nanachan3835/AIR-QUALITY-SENSOR-FIX/pic/ScreenShot_2026-11-03_133047_207.png

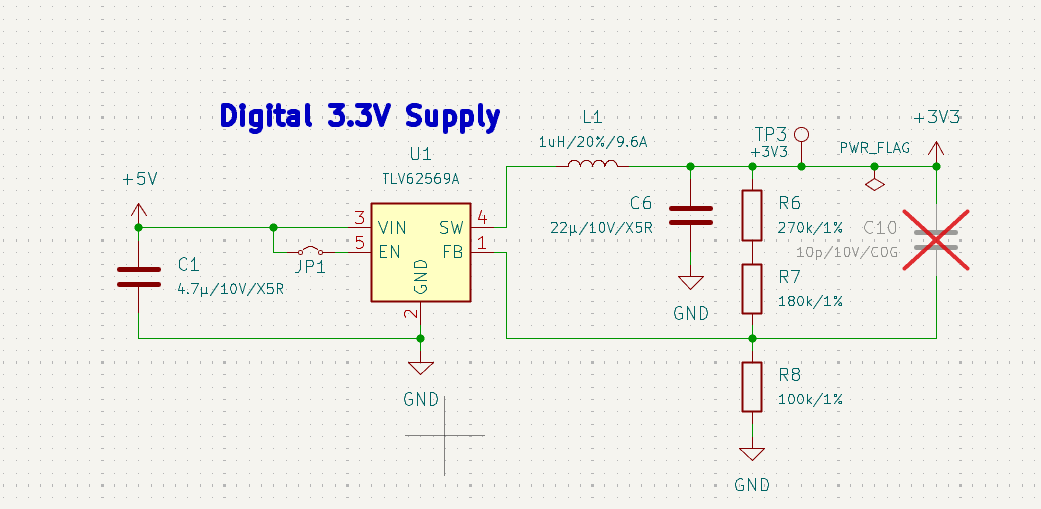
pic/ScreenShot_2026-11-03_133047_207.png
