nanachan3835/AIR-QUALITY-SENSOR-FIX/pic/ScreenShot_2026-11-03_133104_901.png

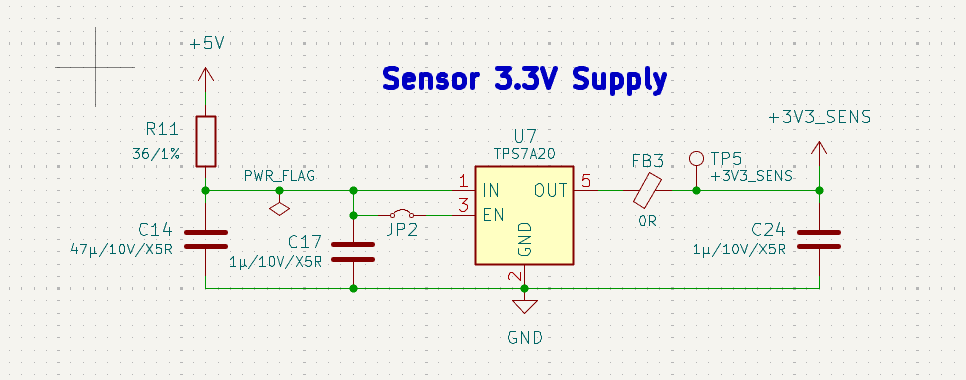
pic/ScreenShot_2026-11-03_133104_901.png
