nanachan3835/AIR-QUALITY-SENSOR-FIX/pic/ScreenShot_2026-11-03_133211_923.png

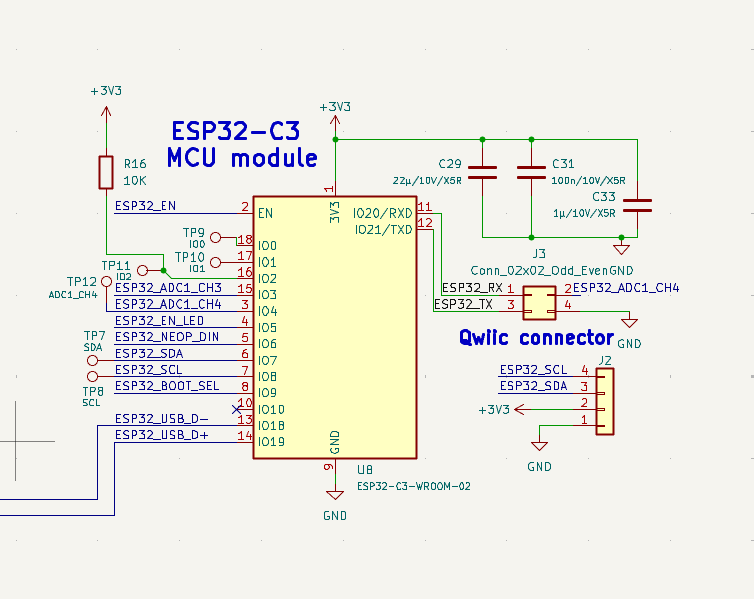
pic/ScreenShot_2026-11-03_133211_923.png
