nanachan3835/AIR-QUALITY-SENSOR-FIX/pic/ScreenShot_2026-11-03_133233_049.png

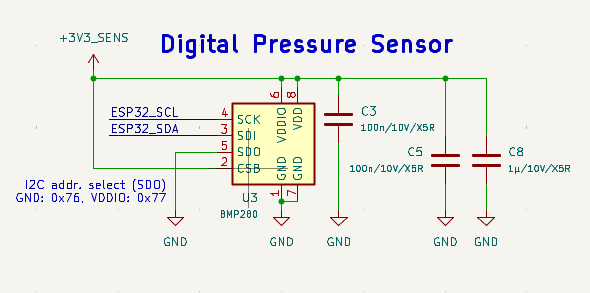
pic/ScreenShot_2026-11-03_133233_049.png
