nanachan3835/AIR-QUALITY-SENSOR-FIX/pic/ScreenShot_2026-11-03_133306_155.png

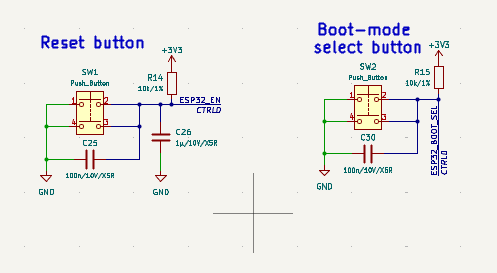
pic/ScreenShot_2026-11-03_133306_155.png
