nanachan3835/AIR-QUALITY-SENSOR-FIX/3dmodels/SGP41-D-R4.step

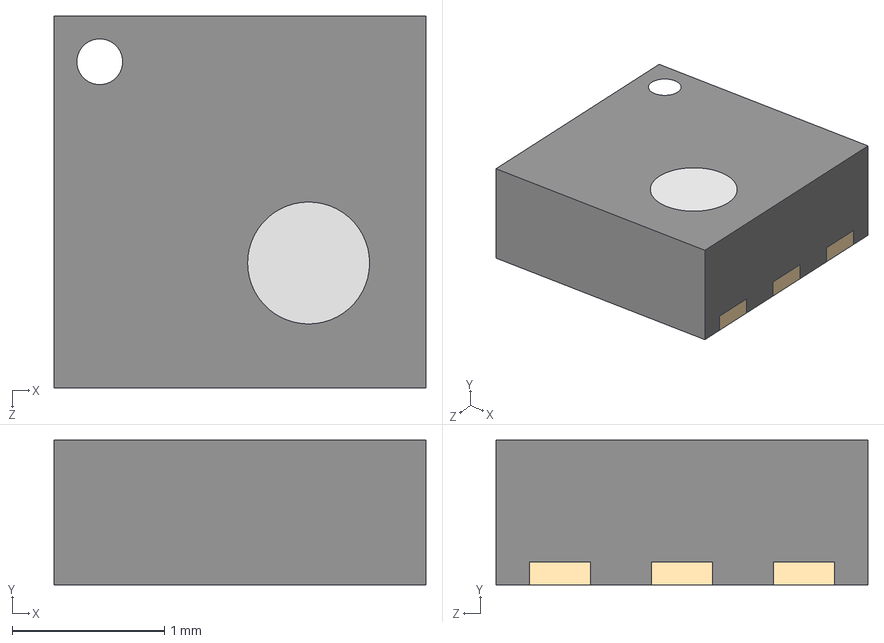
[picture p15: CAD file, 2026-10-27]
3dmodels/SGP41-D-R4.step
2.44 x 0.95 x 2.44 mm
