nanachan3835/AIR-QUALITY-SENSOR-FIX/air_quality_sensor-pcb.step

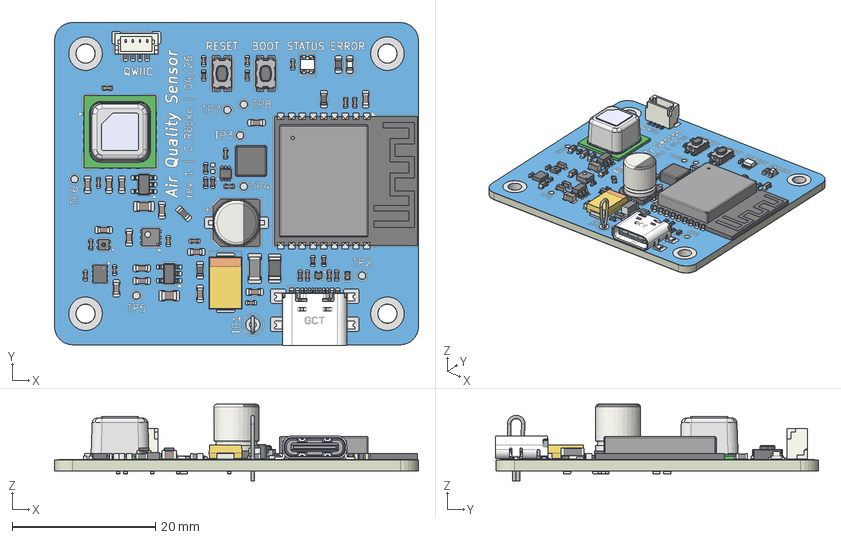
[picture p16: CAD file, 2026-10-27]
air_quality_sensor-pcb.step
50.8 x 45.1 x 10.7 mm
SGP41-D-R4
R_0402_1005Metric x 16
SCD41-D-R2--3DModel-STEP-369182
C_0603_1608Metric x 12
C_0402_1005Metric x 17
C_0805_2012Metric x 2
R_0603_1608Metric x 4
USB4110-GF-A_revB(1) MF
CP_EIA-7343-20_Kemet-V
SW_Push_1P1T_NO_CK_KMR2 x 2
CP_Elec_6.3x7.7
LED_0603_1608Metric
SOT-563
SHT40-AD1B-R3
L_Coilcraft_XAL4020-XXX
TestPoint_Loop_D2.50mm_Drill1.0mm
WS2812-2020--3DModel-STEP-1
Texas_DRT-3
SOT-23-5 x 2
D_SOD-882
ESP32-C3-WROOM-02
L_1206_3216Metric
Bosch_LGA-8_2x2.5mm_P0.65mm_ClockwisePinNumbering
L_0603_1608Metric x 2
JST_SH_BM04B-SRSS-TB_1x04-1MP_P1.00mm_Vertical
Fuse_1206_3216Metric
air_quality_sensor_copper
air_quality_sensor_pad
air_quality_sensor_via
air_quality_sensor_silkscreen x 2
air_quality_sensor_soldermask x 2
air_quality_sensor_PCB
