nanachan3835/AIR-QUALITY-SENSOR-FIX/3dmodels/USB4110-GF-A.step

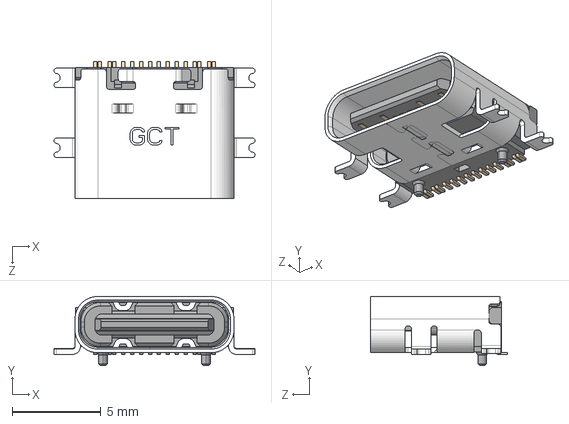
[picture p17: CAD file, 2026-10-27]
3dmodels/USB4110-GF-A.step
11.3 x 3.89 x 7.70 mm
