nanachan3835/AIR-QUALITY-SENSOR-FIX/3dmodels/WS2812-2020--3DModel-STEP-1.STEP

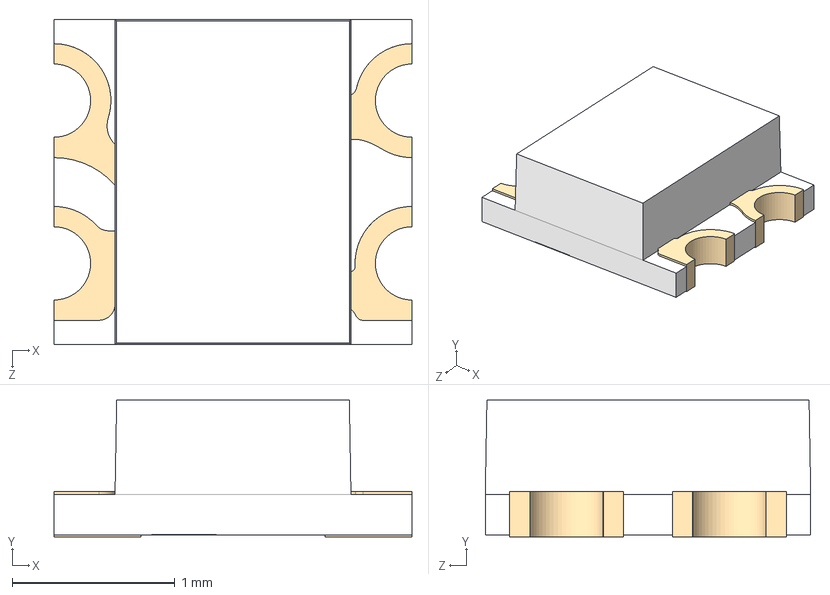
[picture p18: CAD file, 2026-10-27]
3dmodels/WS2812-2020--3DModel-STEP-1.STEP
2.20 x 0.84 x 2.00 mm
