nanachan3835/AIR-QUALITY-SENSOR-FIX/3dmodels/SCD41-D-R2--3DModel-STEP-369182.STEP

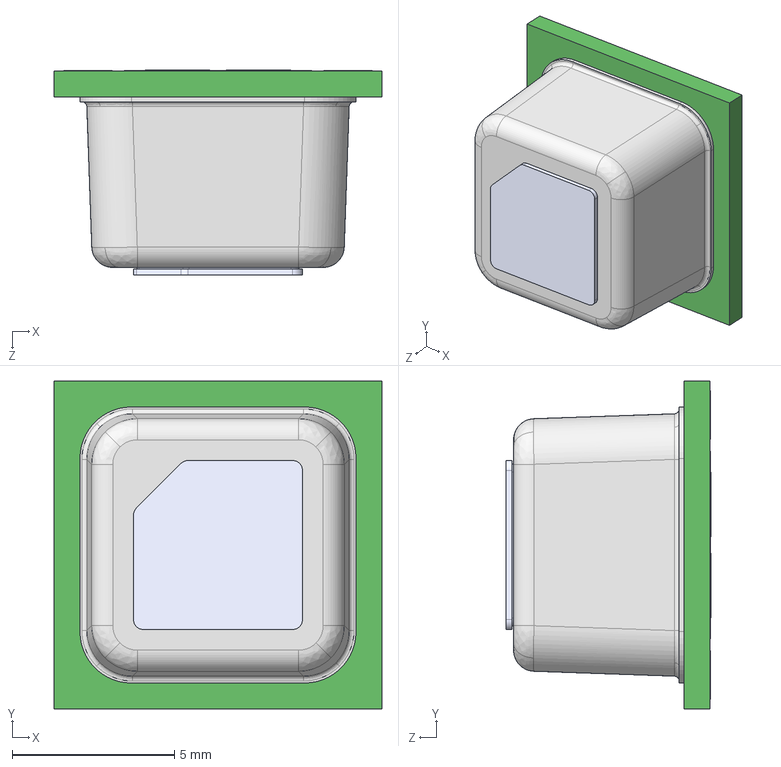
[picture p19: CAD file, 2026-10-27]
3dmodels/SCD41-D-R2--3DModel-STEP-369182.STEP
10.1 x 10.1 x 6.31 mm
