nanachan3835/AIR-QUALITY-SENSOR-FIX/3dmodels/SHT40-AD1B-R3.STEP

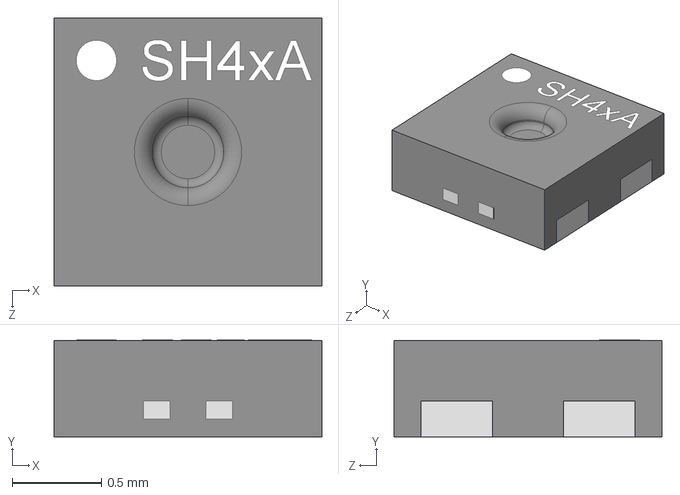
[picture p20: CAD file, 2026-10-27]
3dmodels/SHT40-AD1B-R3.STEP
1.50 x 0.541 x 1.50 mm
