nanachan3835/AIR-QUALITY-SENSOR-FIX/air_quality_sensor.kicad_pcb

## KiCad design air_quality_sensor.kicad_pcb (2026-11-02)

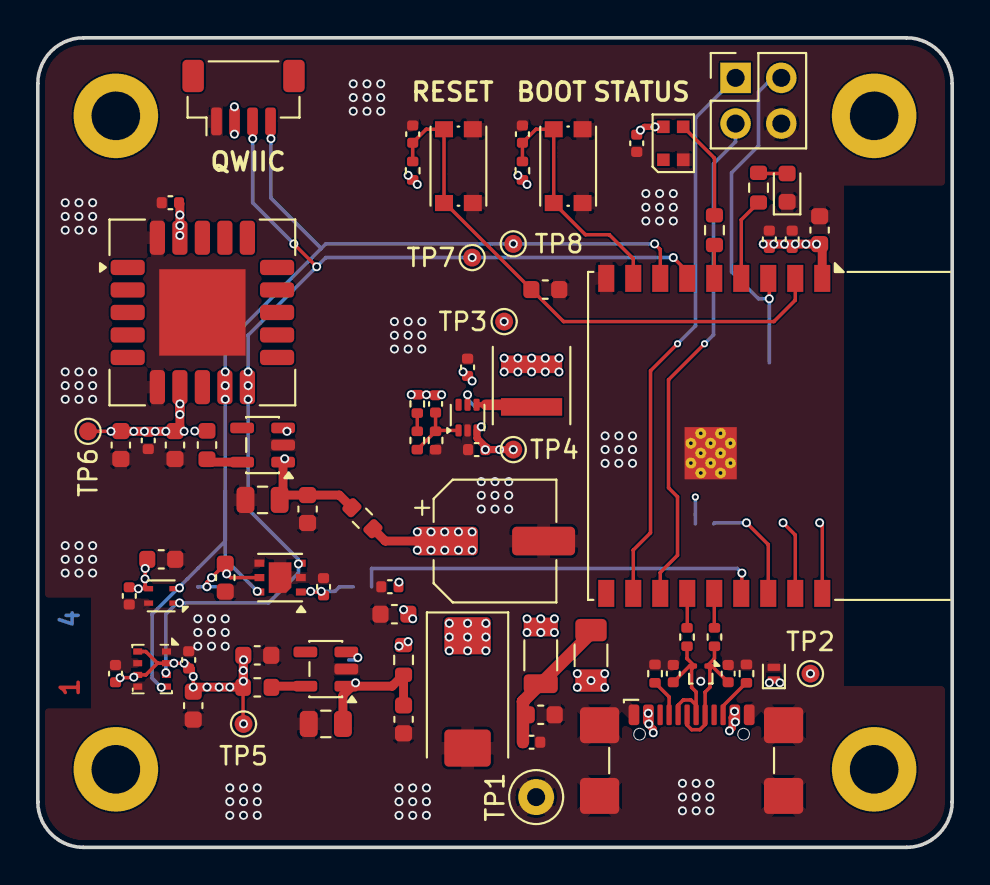
[picture p21: board air_quality_sensor.kicad_pcb from above]

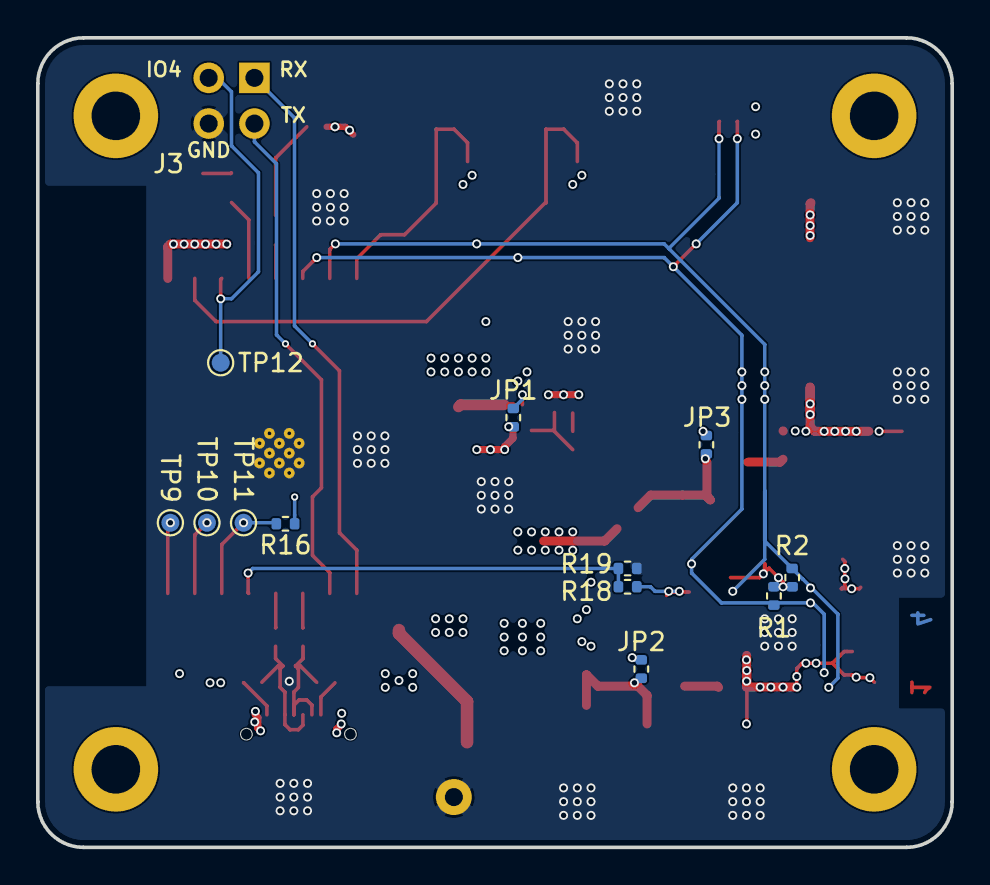
[picture p22: board air_quality_sensor.kicad_pcb from below]

Board: 4 copper layers, 50.8 x 45.0 mm, 93 parts (12 on the bottom side), 38 nets.

Parts:
C1: 4.7µ/10V/X5R; C_0402_1005Metric
C2, C3, C5, C12, C13, C21, C22, C25, C30, C31, C34: 100n/10V/X5R; C_0402_1005Metric
C4, C9, C10: 10p/10V/C0G; C_0402_1005Metric
C6, C29: 22µ/10V/X5R; C_0402_1005Metric
C7, C8, C11, C17, C18, C19, C20, C24, C26, C28, C32, C33: 1µ/10V/X5R; C_0603_1608Metric
C14, C27: 47µ/10V/X5R; C_0805_2012Metric
C15: 100µ/16V; CP_EIA-7343-20_Kemet-V
C16: 1µ/10V/X5R; C_0402_1005Metric
C23: 47u/16V/20%; CP_Elec_6.3x7.7
D1: ESDALC5; D_SOD-882
D2: LED 0603 red; LED_0603_1608Metric
D3: WS2812; LED_WS2812B-2020_PLCC4_2.0x2.0mm
F1: PPTC 8V 750mA; Fuse_1206_3216Metric
FB1, FB3: 0R; L_0603_1608Metric
FB2: 1k@100MHz; L_1206_3216Metric
H1, H2, H3, H4: M3_MountingHole; MountingHole_2.7mm_M2.5_DIN965_Pad
J1: USB4110; USB_C_Receptacle_GCT_USB4110
J2: QWIIC Connector; JST_SH_BM04B-SRSS-TB_1x04-1MP_P1.00mm_Vertical
J3: Conn_02x02_Odd_Even; PinHeader_2x02_P2.54mm_Vertical
JP1, JP2, JP3: 0/1%; R_0402_1005Metric
L1: 1uH/20%/9.6A; L_Coilcraft_XxL4020
R1, R2: 4.7k/1%; R_0402_1005Metric
R3, R9: 22/1%; R_0402_1005Metric
R4, R5: 5.1k/1%; R_0402_1005Metric
R6: 270k/1%; R_0402_1005Metric
R7: 180k/1%; R_0402_1005Metric
R8: 100k/1%; R_0402_1005Metric
R10, R12: 330/1%; R_0603_1608Metric
R11: 36/1%; R_0603_1608Metric
R13: 0/1%; R_0603_1608Metric
R14, R15, R18, R19: 10k/1%; R_0402_1005Metric
R16: 10K; R_0402_1005Metric
SW1, SW2: Push_Button; SW_Push_1P1T_NO_CK_KMR2
TP1: GND; TestPoint_Loop_D2.50mm_Drill1.0mm
TP2: VBUS; TestPoint_Pad_D1.0mm
TP3: +3V3; TestPoint_Pad_D1.0mm
TP4: 5V; TestPoint_Pad_D1.0mm
TP5: +3V3_SENS; TestPoint_Pad_D1.0mm
TP6: 3V3_SCD; TestPoint_Pad_D1.0mm
TP7: SDA; TestPoint_Pad_D1.0mm
TP8: SCL; TestPoint_Pad_D1.0mm
TP9: IO0; TestPoint_Pad_D1.0mm
TP10: IO1; TestPoint_Pad_D1.0mm
TP11: IO2; TestPoint_Pad_D1.0mm
TP12: ADC1_CH4; TestPoint_Pad_D1.0mm
U1: TLV62569A; SOT-563
U2: SHT40; Sensirion_DFN-4_1.5x1.5mm_P0.8mm_SHT4x_NoCentralPad
U3: BMP280; Bosch_LGA-8_2x2.5mm_P0.65mm_ClockwisePinNumbering
U4: TPD2EUSB30; Texas_DRT-3
U5: SCD41; Sensirion_SCD4x-1EP_10.1x10.1mm_P1.25mm_EP4.8x4.8mm
U6: SGP41; XDCR_SGP41-D-R4
U7: TPS7A20; SOT-23-5
U8: ESP32-C3-WROOM-02
U9: TLV75533P; SOT-23-5

Connections:
+3V3: C6.1, C10.1, C29.1, C31.1, C33.1, J2.2, L1.2, R6.1, R14.1, R15.1, R16.1, TP3.1 (1_1), U8.1 (3V3)
+3V3_SCD: C13.1, C18.1, C32.1, C34.1, FB1.2, TP6.1 (1_1), U5.7 (VDD), U5.19 (VDD)
+3V3_SENS: C2.1, C3.1, C5.1, C7.1, C8.1, C16.1, C20.1, C24.1, FB3.2, R1.1, R2.1, R18.1, TP5.1 (1_1), U2.3 (VDD), U3.2 (CSB), U3.6 (VDDIO), U3.8 (VDD), U6.1 (VDD), U6.5 (VDDH)
+5V: C1.1, C15.1, C19.1, C21.1, C22.1, C23.1, D3.4 (VDD), FB2.2, JP1.1 (A), R11.1, R13.1, TP4.1 (1_1), U1.3 (VIN)
/ESP32_ADC1_CH3: R18.2, R19.1, U8.15 (IO3)
/ESP32_ADC1_CH4: J3.2, TP12.1 (1_1), U8.3 (IO4)
/ESP32_BOOT_SEL: C30.1, R15.2, SW2.2, U8.8 (IO9)
/ESP32_EN: C25.1, C26.1, R14.2, SW1.2, U8.2 (EN)
/ESP32_EN_LED: R10.1, U8.4 (IO5)
/ESP32_NEOP_DIN: R12.1, U8.5 (IO6)
/ESP32_RX: J3.1, U8.11 (IO20/RXD)
/ESP32_SCL: J2.4, R2.2, TP8.1 (1_1), U2.2 (SCL), U3.4 (SCK), U5.9 (SCL), U6.6 (SCL), U8.7 (IO8)
/ESP32_SDA: J2.3, R1.2, TP7.1 (1_1), U2.1 (SDA), U3.3 (SDI), U5.10 (SDA), U6.3 (SDA), U8.6 (IO7)
/ESP32_TX: J3.3, U8.12 (IO21/TXD)
/ESP32_USB_D+: R3.2, U8.14 (IO19)
/ESP32_USB_D-: R9.2, U8.13 (IO18)
/USB_D+: C4.1, J1.A6 (D+), J1.B6 (D+), R3.1, U4.1 (D+)
/USB_D-: C9.1, J1.A7 (D-), J1.B7 (D-), R9.1, U4.2 (D-)
GND: C1.2, C2.2, C3.2, C4.2, C5.2, C6.2, C7.2, C8.2, C9.2, C11.2, C12.2, C13.2, C14.2, C15.2, C16.2, C17.2, C18.2, C19.2, C20.2, C21.2, C22.2, C23.2, C24.2, C25.2, C26.2, C27.2, C28.2, C29.2, C30.2, C31.2, C32.2, C33.2, C34.2, D1.2 (A), D2.1 (K), D3.2 (VSS), J1.A1 (GND), J1.A12 (GND), J1.B1 (GND), J1.B12 (GND), J1.S1 (SHIELD), J2.1, J3.4, R4.2, R5.2, R8.2, R19.2, SW1.1, SW2.1, TP1.1 (1_1), U1.2 (GND), U2.4 (VSS), U3.1 (GND), U3.5 (SDO), U3.7 (GND), U4.3 (GND), U5.6 (GND), U5.20 (GND), U5.21 (GND), U6.2 (VSS), U6.4 (N/A), U6.7 (EP), U7.2 (GND), U8.9 (GND), U8.19 (GND), U9.2 (GND)
unnamed: C11.1, C12.1, F1.2, FB2.1
unnamed: D2.2 (A), R10.2
unnamed: D3.3 (DIN), R12.2
unnamed: J1.A5 (CC1), R4.1
unnamed: J1.B5 (CC2), R5.1
unnamed: JP1.2 (B), U1.5 (EN)
unnamed: C14.1, C17.1, JP2.1 (A), R11.2, U7.1 (IN)
unnamed: JP2.2 (B), U7.3 (EN)
unnamed: C27.1, C28.1, JP3.1 (A), R13.2, U9.1 (IN)
unnamed: JP3.2 (B), U9.3 (EN)
unnamed: R6.2, R7.1
unnamed: C10.2, R7.2, R8.1, U1.1 (FB)
unnamed: L1.1, U1.4 (SW)
unnamed: FB3.1, U7.5 (OUT)
unnamed: TP9.1 (1_1), U8.18 (IO0)
unnamed: TP10.1 (1_1), U8.17 (IO1)
unnamed: R16.2, TP11.1 (1_1), U8.16 (IO2)
unnamed: FB1.1, U9.5 (OUT)
VBUS: D1.1 (K), F1.1, J1.A4 (VBUS), J1.A9 (VBUS), J1.B4 (VBUS), J1.B9 (VBUS), TP2.1 (1_1)
