nanachan3835/AIR-QUALITY-SENSOR-FIX/(commit log)

2026-10-27 Baseline: air quality sensor PCB before MCP sandbox use
    [BOM-air_quality_sensor.csv, SCD41-D-R2--3DModel-STEP-369182.STEP, SGP41-D-R4.step, SHT40-AD1B-R3.STEP, USB4110-GF-A.step, WS2812-2020--3DModel-STEP-1.STEP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]
2026-10-27 Disable line-ending conversion for KiCad files
    [BOM-air_quality_sensor.csv, SCD41-D-R2--3DModel-STEP-369182.STEP, SGP41-D-R4.step, SHT40-AD1B-R3.STEP, USB4110-GF-A.step, WS2812-2020--3DModel-STEP-1.STEP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]
2026-11-01 add uart adc and GND header, drc and erc got no new error, add silk screen at header pin, bottom silk screen, the warning still not solve
    [air_quality_sensor.kicad_pcb, air_quality_sensor.kicad_sch]
2026-11-02 FIX:add pull up resistor R16 from IO2 to 3V3+(datasheet recommend), make esp32 balance boost up
    [air_quality_sensor-B_Cu.gbl, air_quality_sensor-B_Mask.gbs, air_quality_sensor-B_Paste.gbp, air_quality_sensor-B_Silkscreen.gbo, air_quality_sensor-Edge_Cuts.gm1, air_quality_sensor-F_Cu.gtl, air_quality_sensor-F_Mask.gts, air_quality_sensor-F_Paste.gtp]
2026-11-03 FIX: change footprint of R16 from 0603 to 0402
    [air_quality_sensor-B_Cu.gbl, air_quality_sensor-B_Mask.gbs, air_quality_sensor-B_Paste.gbp, air_quality_sensor-B_Silkscreen.gbo, air_quality_sensor-Edge_Cuts.gm1, air_quality_sensor-F_Cu.gtl, air_quality_sensor-F_Mask.gts, air_quality_sensor-F_Paste.gtp]
